hd-faria/MicroMod_Artemis_Processor/Hardware/MicroMod-Artemis-ProcessorBoard.brd

## EAGLE design Hardware/MicroMod-Artemis-ProcessorBoard.brd (2020-11-06)

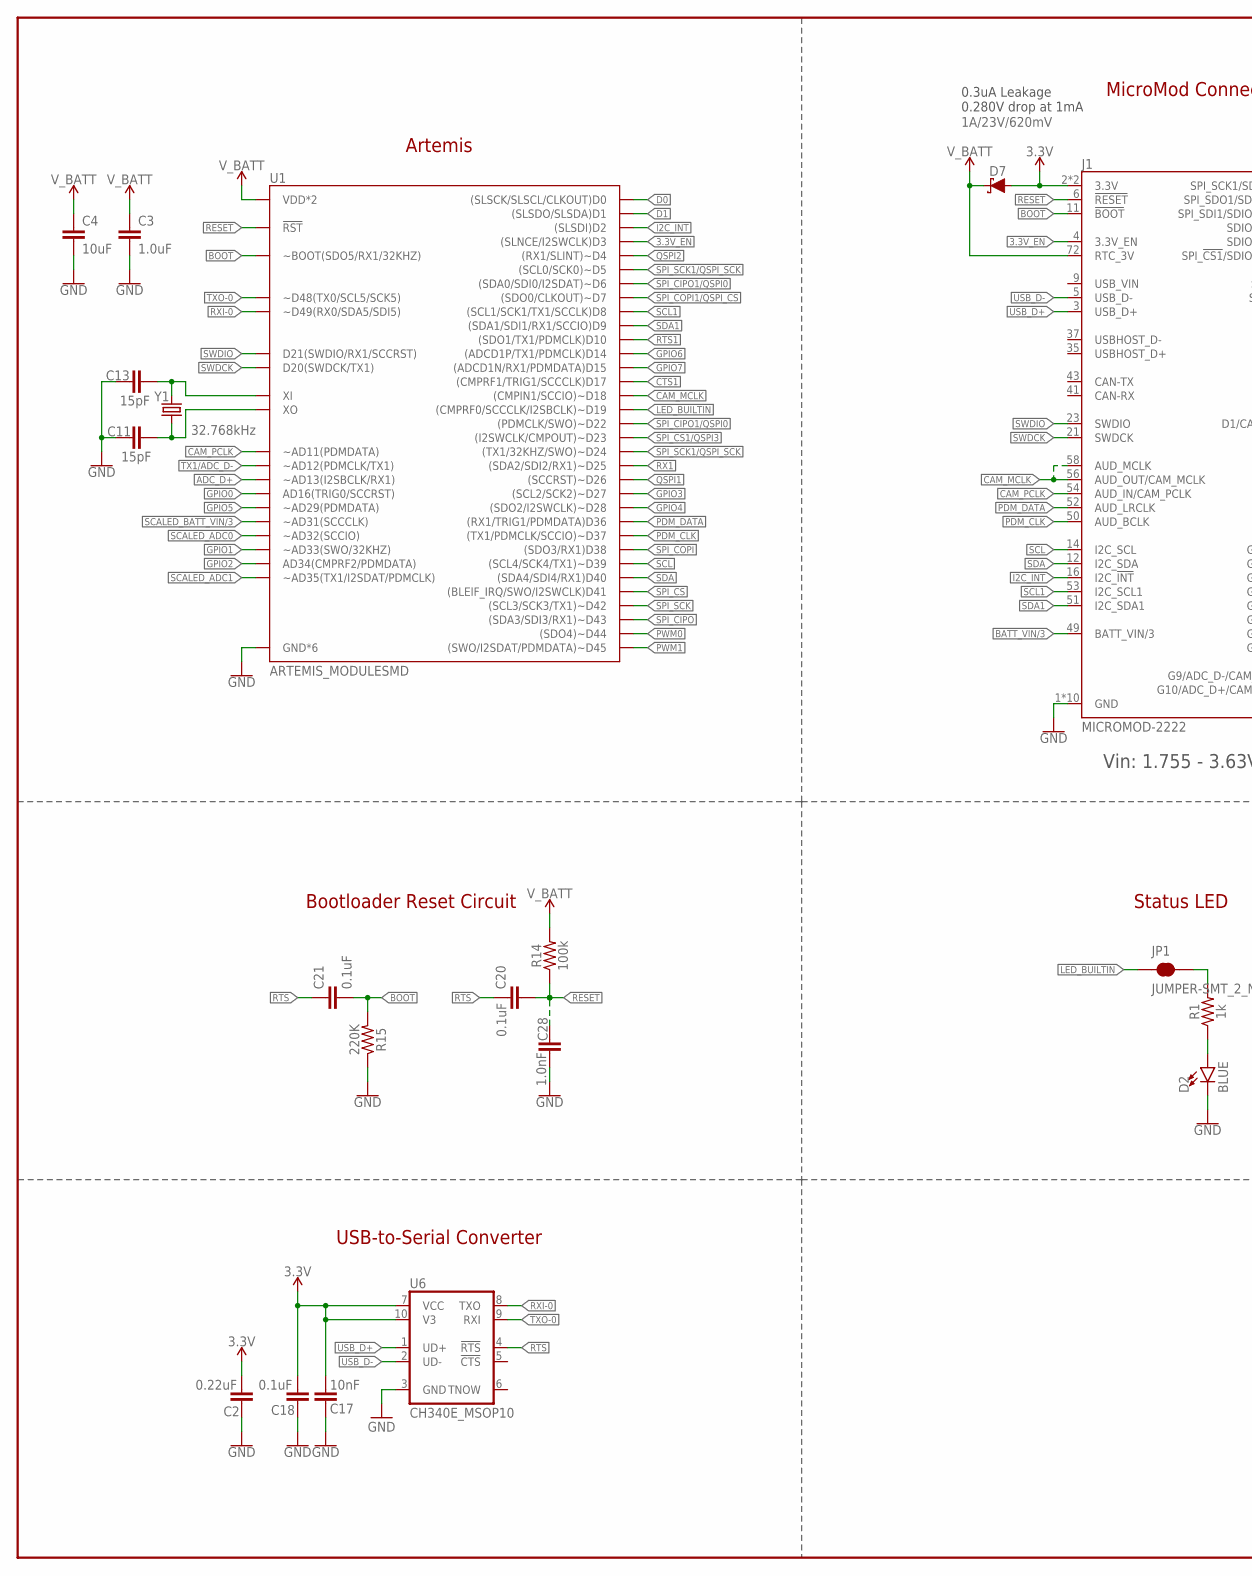
[picture p1: schematic MicroMod-Artemis-ProcessorBoard.sch, part in row 1, column 1]

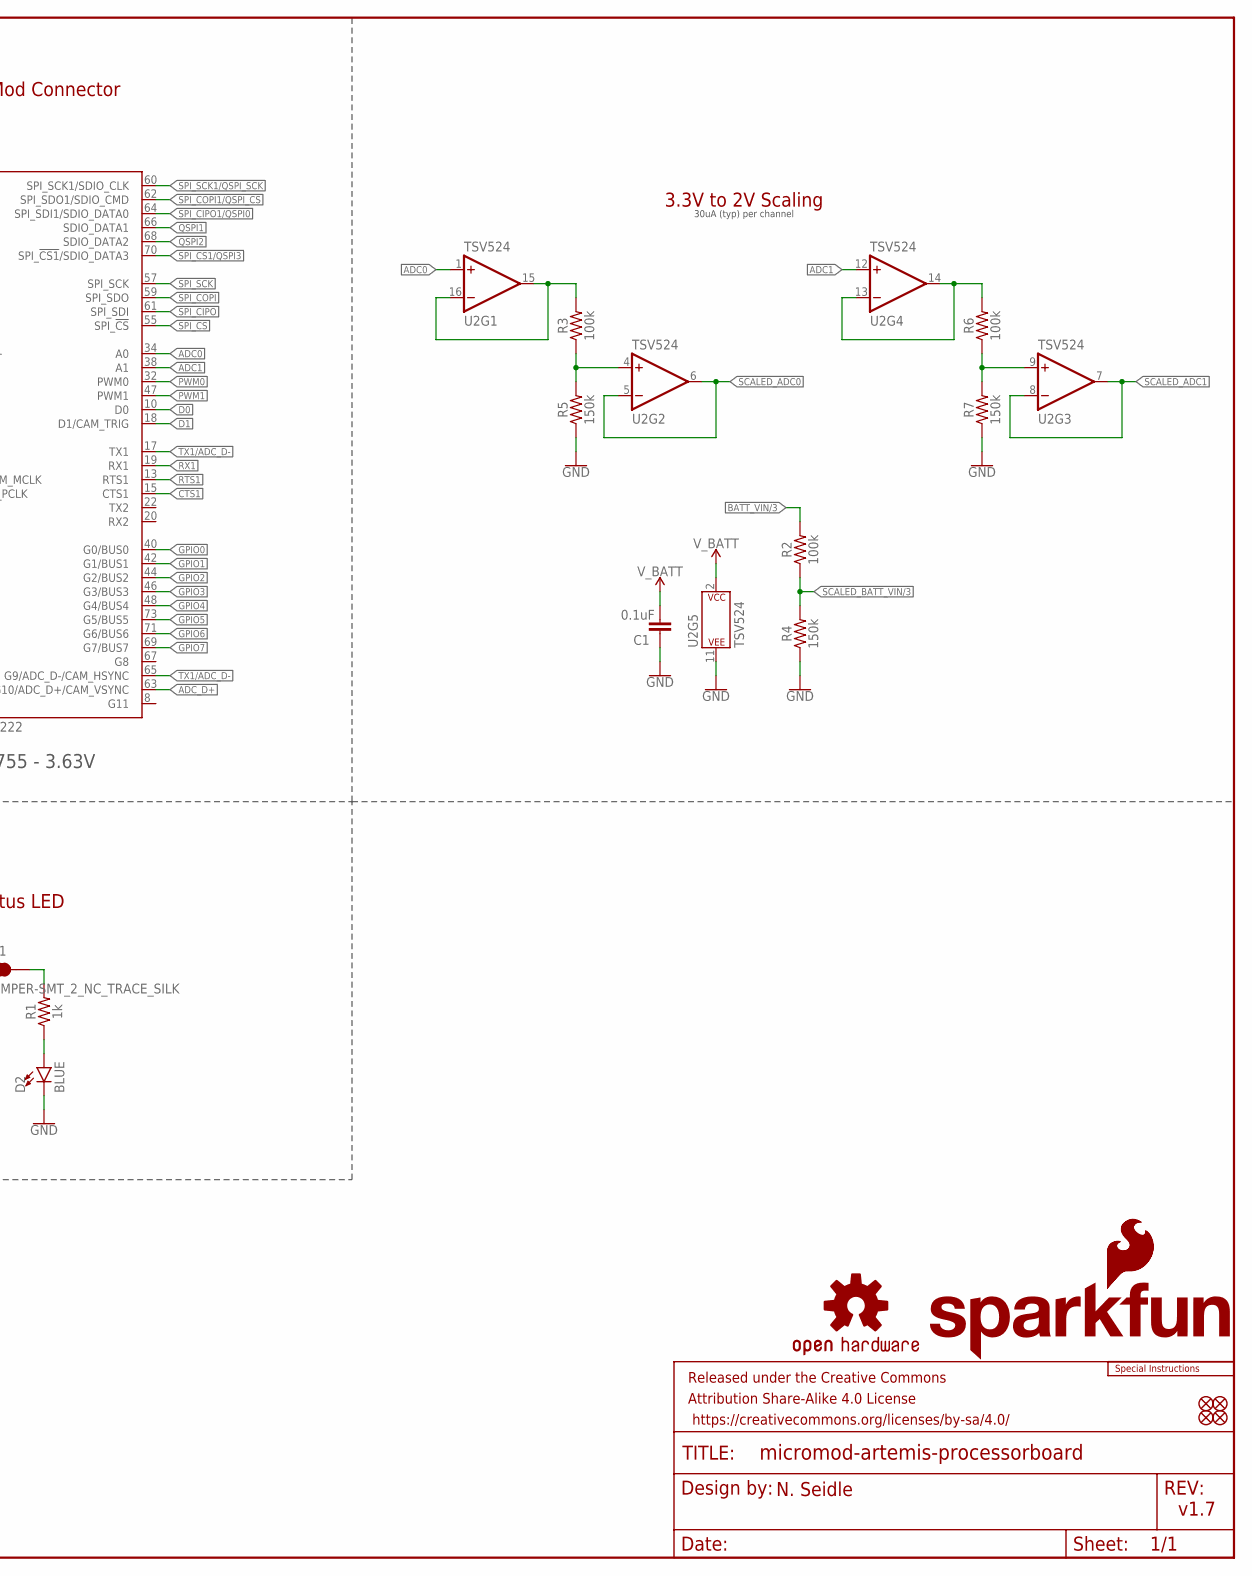
[picture p2: schematic MicroMod-Artemis-ProcessorBoard.sch, part in row 1, column 2]

Parts:
C1, C18, C20, C21: 0.1uF; 0402-TIGHT
C2: 0.22uF; 0402-TIGHT
C3: 1.0uF; 0402-TIGHT
C4: 10uF; 0603
C11, C13: 15pF; 0402-TIGHT
C17: 10nF; 0402-TIGHT
C28: 1.0nF; 0402-TIGHT
D2: BLUE; LED-0603
D7: 1A/23V/620mV; SOD-323
FD1, FD2, FD3, FD4: FIDUCIALUFIDUCIAL; FIDUCIAL-MICRO
FRAME1: FRAME-LEDGER; CREATIVE_COMMONS
J1: MICROMOD-2222; M.2-CARD-E-22
JP1: JUMPER-SMT_2_NC_TRACE_SILK; SMT-JUMPER_2_NC_TRACE_SILK
LOGO1: SFE_LOGO_NAME_FLAME.1_INCH; SFE_LOGO_NAME_FLAME_.1
LOGO2: SFE_LOGO_FLAME.1_INCH; SFE_LOGO_FLAME_.1
LOGO3: OSHW-LOGOMINI; OSHW-LOGO-MINI
LOGO4: SPECIAL_INSTRUCTIONS-ORDERING; ORDERING_INSTRUCTIONS
R1: 1k; 0402-TIGHT
R2, R3, R6, R14: 100k; 0402-TIGHT
R4, R5, R7: 150k; 0402-TIGHT
R15: 220K; 0402-TIGHT
U1: ARTEMIS_MODULESMD; ARTEMIS_FP
U2: TSV524; QFN-16
U6: CH340E_MSOP10; MSOP10
Y1: 32.768kHz; CRYSTAL-SMD-3.2X1.5MM

Connections:
3.3V: C2.1, C17.1, C18.1, D7.A, J1.2 (3.3V), J1.74 (3.3V), U6.7 (VCC), U6.10 (V3)
3.3V_EN: J1.4 (3.3V_EN), U1.D3 ((SLNCE/I2SWCLK)D3)
!RESET!: C20.2, C28.1, J1.6 (!RESET!), R14.1, U1.~RST (!RST)
!RTS: C20.1, C21.1, U6.4 (!RTS)
ADC0: J1.34 (A0), U2.1 (+IN)
ADC0_BUFF1: R3.2, U2.15 (OUT), U2.16 (-IN)
ADC0_BUFF2: R3.1, R5.2, U2.4 (+IN)
ADC1: J1.38 (A1), U2.12 (+IN)
ADC1_BUFF2: R6.1, R7.2, U2.9 (+IN)
ADC_BUFF1: R6.2, U2.13 (-IN), U2.14 (OUT)
ADC_D+: J1.63 (G10/ADC_D+/CAM_VSYNC), U1.~AD13 (~AD13(I2SBCLK/RX1))
BATT_VIN/3: J1.49 (BATT_VIN/3), R2.2
BOOT: C21.2, J1.11 (!BOOT!), R15.2, U1.BOOT (~BOOT(SDO5/RX1/32KHZ))
CAM_MCLK: J1.56 (AUD_OUT/CAM_MCLK), J1.58 (AUD_MCLK), U1.~D18 ((CMPIN1/SCCIO)~D18)
CAM_PCLK: J1.54 (AUD_IN/CAM_PCLK), U1.~AD11 (~AD11(PDMDATA))
CTS1: J1.15 (CTS1), U1.D17 ((CMPRF1/TRIG1/SCCCLK)D17)
D0: J1.10 (D0), U1.D0 ((SLSCK/SLSCL/CLKOUT)D0)
D1: J1.18 (D1/CAM_TRIG), U1.D1 ((SLSDO/SLSDA)D1)
GND: C1.2, C2.2, C3.2, C4.2, C11.1, C13.1, C17.2, C18.2, C28.2, D2.C, J1.1 (GND), J1.7 (GND), J1.33 (GND), J1.36 (GND), J1.39 (GND), J1.45 (GND), J1.75 (GND), J1.GND1 (GND), J1.GND2 (GND), J1.GND3 (GND), R4.1, R5.1, R7.1, R15.1, U1.GND@1 (GND*6), U1.GND@22 (GND*6), U1.GND@38 (GND*6), U1.GND@39 (GND*6), U1.GND@47 (GND*6), U1.GND@59 (GND*6), U2.11 (V-), U6.3 (GND)
GPIO0: J1.40 (G0/BUS0), U1.AD16 (AD16(TRIG0/SCCRST))
GPIO1: J1.42 (G1/BUS1), U1.~AD33/SWO (~AD33(SWO/32KHZ))
GPIO2: J1.44 (G2/BUS2), U1.AD34 (AD34(CMPRF2/PDMDATA))
GPIO3: J1.46 (G3/BUS3), U1.~D27 ((SCL2/SCK2)~D27)
GPIO4: J1.48 (G4/BUS4), U1.~D28 ((SDO2/I2SWCLK)~D28)
GPIO5: J1.73 (G5/BUS5), U1.~AD29 (~AD29(PDMDATA))
GPIO6: J1.71 (G6/BUS6), U1.D14 ((ADCD1P/TX1/PDMCLK)D14)
GPIO7: J1.69 (G7/BUS7), U1.D15 ((ADCD1N/RX1/PDMDATA)D15)
I2C_!INT!: J1.16 (I2C_!INT!), U1.D2 ((SLSDI)D2)
LED_BUILTIN: JP1.1, U1.~D19 ((CMPRF0/SCCCLK/I2SBCLK)~D19)
unnamed: JP1.2, R1.2
unnamed: D2.A, R1.1
unnamed: C13.2, U1.XI, Y1.P$1 (1)
unnamed: C11.2, U1.XO, Y1.P$2 (2)
PDM_CLK: J1.50 (AUD_BCLK), U1.~D37 ((TX1/PDMCLK/SCCIO)~D37)
PDM_DATA: J1.52 (AUD_LRCLK), U1.D36 ((RX1/TRIG1/PDMDATA)D36)
PWM0: J1.32 (PWM0), U1.~D44 ((SDO4)~D44)
PWM1: J1.47 (PWM1), U1.~D45 ((SWO/I2SDAT/PDMDATA)~D45)
QSPI1: J1.66 (SDIO_DATA1), U1.~D26 ((SCCRST)~D26)
QSPI2: J1.68 (SDIO_DATA2), U1.~D4 ((RX1/SLINT)~D4)
RTS1: J1.13 (RTS1), U1.D10 ((SDO1/TX1/PDMCLK)D10)
RX1: J1.19 (RX1), U1.~D25 ((SDA2/SDI2/RX1)~D25)
RXI-0: U1.RXI-0 (~D49(RX0/SDA5/SDI5)), U6.8 (TXO)
SCALED_ADC0: U1.~AD32 (~AD32(SCCIO)), U2.5 (-IN), U2.6 (OUT)
SCALED_ADC1: U1.~AD35 (~AD35(TX1/I2SDAT/PDMCLK)), U2.7 (OUT), U2.8 (-IN)
SCALED_BATT_VIN/3: R2.1, R4.2, U1.~AD31 (~AD31(SCCCLK))
SCL: J1.14 (I2C_SCL), U1.~D39 ((SCL4/SCK4/TX1)~D39)
SCL1: J1.53 (I2C_SCL1), U1.D8 ((SCL1/SCK1/TX1/SCCLK)D8)
SDA: J1.12 (I2C_SDA), U1.D40 ((SDA4/SDI4/RX1)D40)
SDA1: J1.51 (I2C_SDA1), U1.D9 ((SDA1/SDI1/RX1/SCCIO)D9)
SPI_!CS1!/QSPI3: J1.70 (SPI_!CS1!/SDIO_DATA3), U1.~D23 ((I2SWCLK/CMPOUT)~D23)
SPI_!CS!: J1.55 (SPI_!CS!), U1.D41 ((BLEIF_IRQ/SWO/I2SWCLK)D41)
SPI_CIPO: J1.61 (SPI_SDI), U1.~D43 ((SDA3/SDI3/RX1)~D43)
SPI_CIPO1/QSPI0: J1.64 (SPI_SDI1/SDIO_DATA0), U1.~D6 ((SDA0/SDI0/I2SDAT)~D6), U1.~D22 ((PDMCLK/SWO)~D22)
SPI_COPI: J1.59 (SPI_SDO), U1.D38 ((SDO3/RX1)D38)
SPI_COPI1/QSPI_!CS!: J1.62 (SPI_SDO1/SDIO_CMD), U1.D7 ((SDO0/CLKOUT)~D7)
SPI_SCK: J1.57 (SPI_SCK), U1.~D42 ((SCL3/SCK3/TX1)~D42)
SPI_SCK1/QSPI_SCK: J1.60 (SPI_SCK1/SDIO_CLK), U1.~D5 ((SCL0/SCK0)~D5), U1.~D24 ((TX1/32KHZ/SWO)~D24)
SWDCK: J1.21 (SWDCK), U1.SWDCK (D20(SWDCK/TX1))
SWDIO: J1.23 (SWDIO), U1.SWDIO (D21(SWDIO/RX1/SCCRST))
TX1/ADC_D-: J1.17 (TX1), J1.65 (G9/ADC_D-/CAM_HSYNC), U1.~AD12 (~AD12(PDMCLK/TX1))
TXO-0: U1.TXO-0 (~D48(TX0/SCL5/SCK5)), U6.9 (RXI)
USB_D+: J1.3 (USB_D+), U6.1 (UD+)
USB_D-: J1.5 (USB_D-), U6.2 (UD-)
V_BATT: C1.1, C3.1, C4.1, D7.C, J1.72 (RTC_3V), R14.2, U1.VDD@36 (VDD*2), U1.VDD@37 (VDD*2), U2.2 (V+)

Notes on the sheet:
USB-to-Serial Converter
Bootloader Reset Circuit
MicroMod Connector
3.3V to 2V Scaling
v1.7
N. Seidle
Artemis
Status LED
Vin: 1.755 - 3.63V
0.3uA Leakage 0.280V drop at 1mA
30uA (typ) per channel

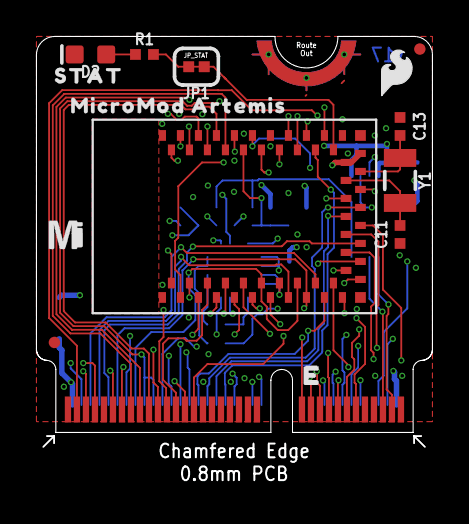
[picture p3: board MicroMod-Artemis-ProcessorBoard.brd from above]

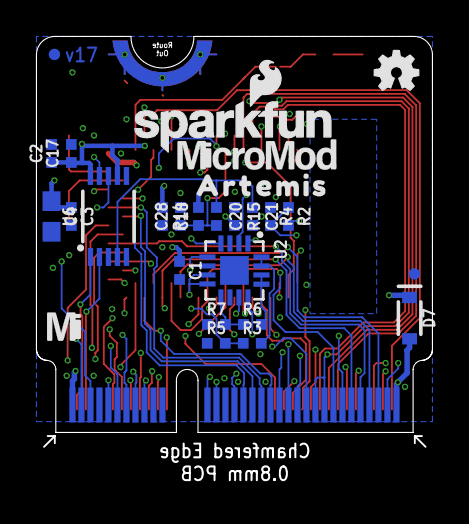
[picture p4: board MicroMod-Artemis-ProcessorBoard.brd from below]

Board: 4 copper layers, 22.0 x 22.8 mm, 43 parts (27 on the bottom side), 64 nets.

Other parts of the board:
U$1, U$7: MICROMOD_MI_LOGO_.35
U$5: MICROMOD_LOGO_.35
U$8: MICROMOD_ARTEMIS0
U$9: ARTEMIS0
U$11: STAT0
